combi-3d/CoMBI-Universal/PCB.png

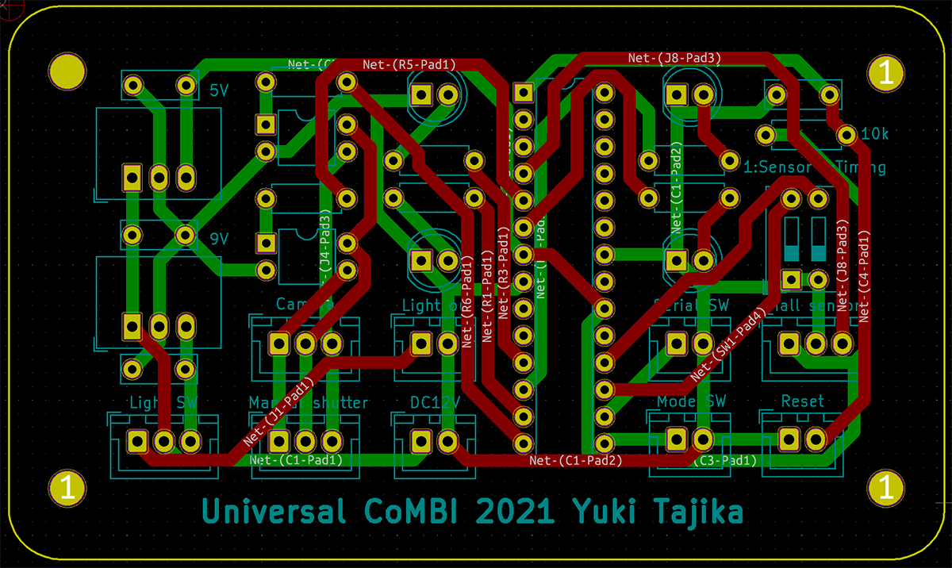
PCB.png
