combi-3d/CoMBI-Universal/Circuit.png

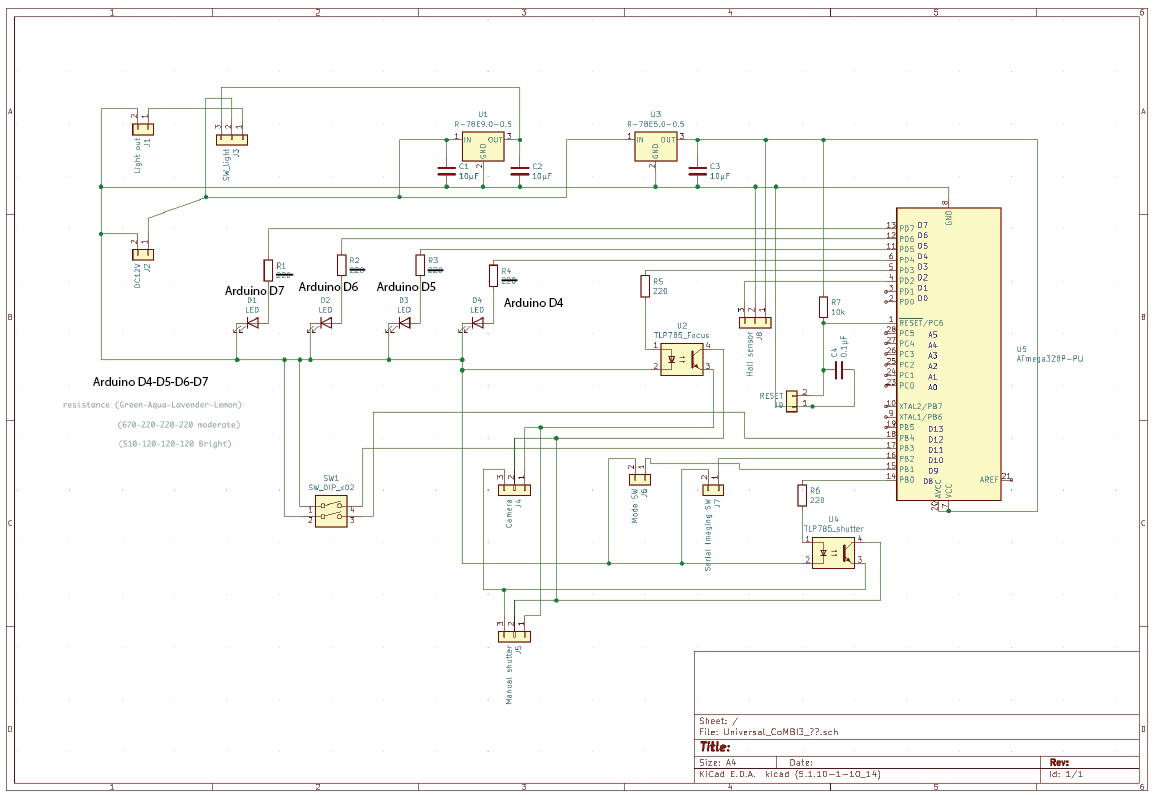
Circuit.png
