combi-3d/CoMBI-Universal/Wiring.png

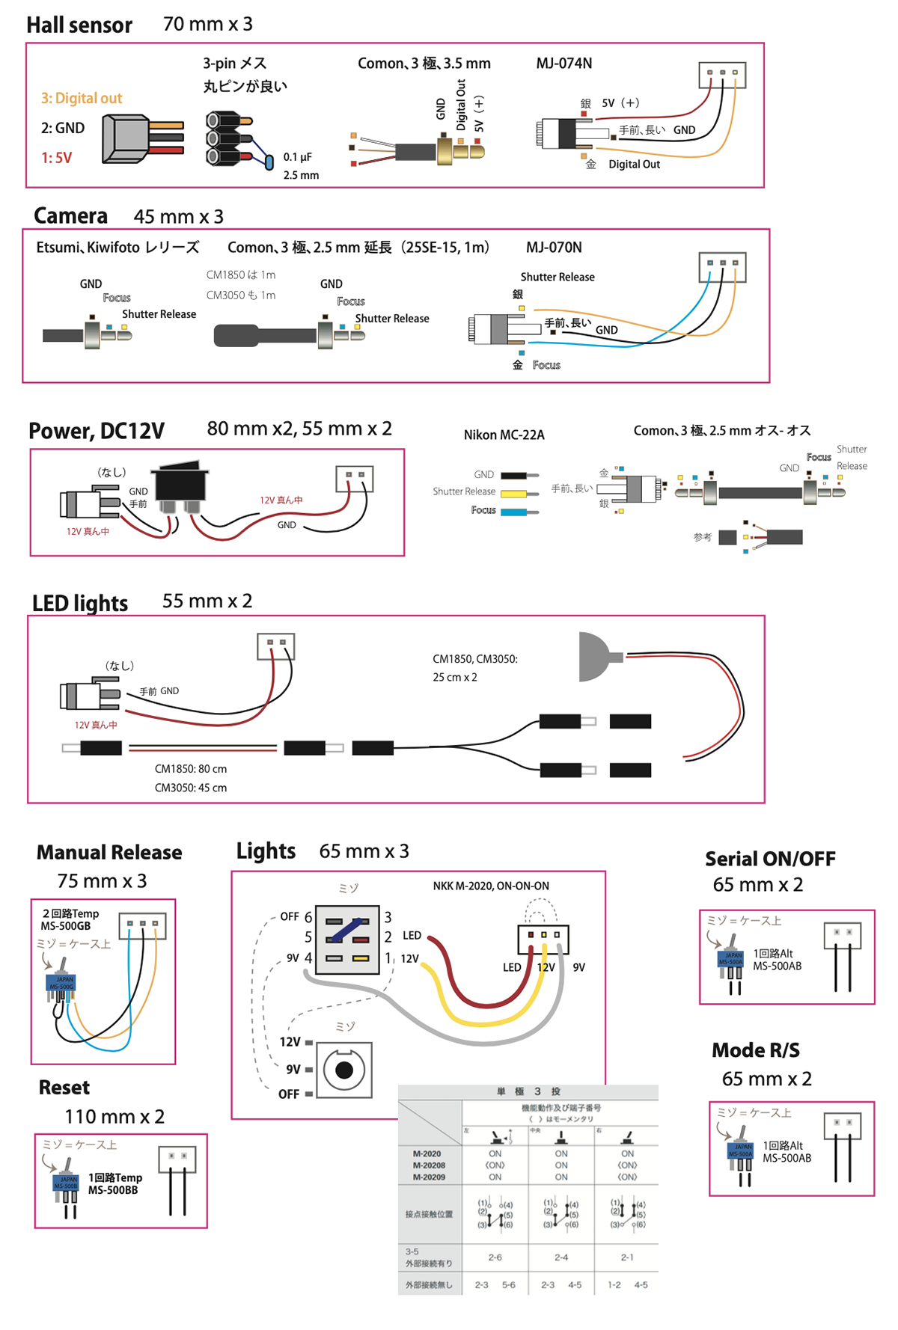
Wiring.png
